YuriTiutvin/audio-spectrum-visualizer/hardware/wiring-diagram.png

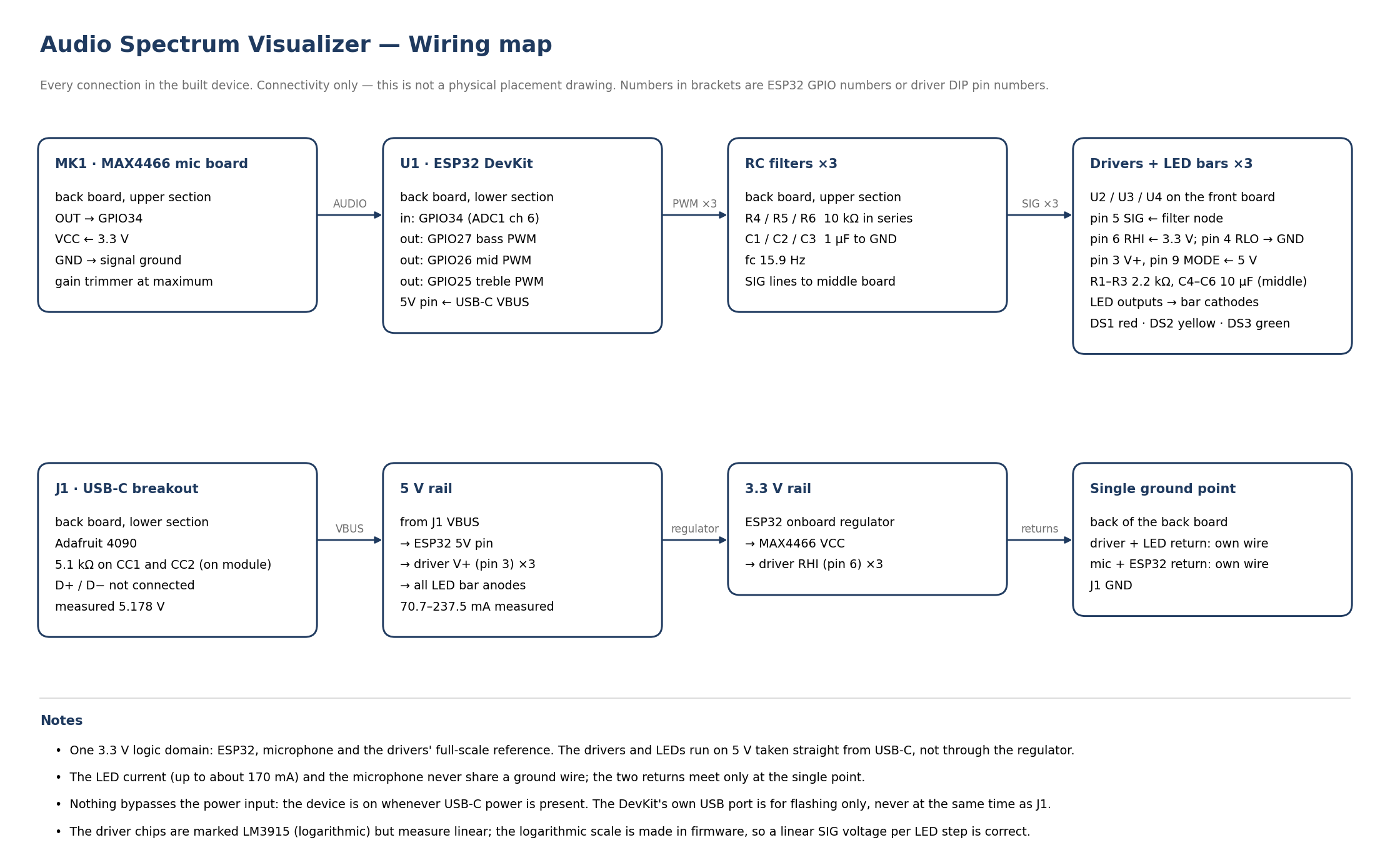
hardware/wiring-diagram.png
