YuriTiutvin/audio-spectrum-visualizer/(commit log)

2026-09-25 Add raw ADC readout sketch
2026-09-25 Add bill of materials
    [bom.csv]
2026-09-25 Add schematic drawn from the netlist
2026-09-25 Add wiring map
2026-09-25 Add driver threshold measurements
2026-09-25 Add ESP32 ADC transfer curve
2026-09-25 Add oscilloscope captures of the PWM filter
2026-09-26 Fix bill of materials
    [bom.csv]
2026-09-26 Redraw schematic as vector graphics
2026-09-26 Label all three capacitors in detail photos
2026-09-26 Remove breadboard power photo from development log
